l-bellier/cva6-ffturbo/report/results_on_board.png

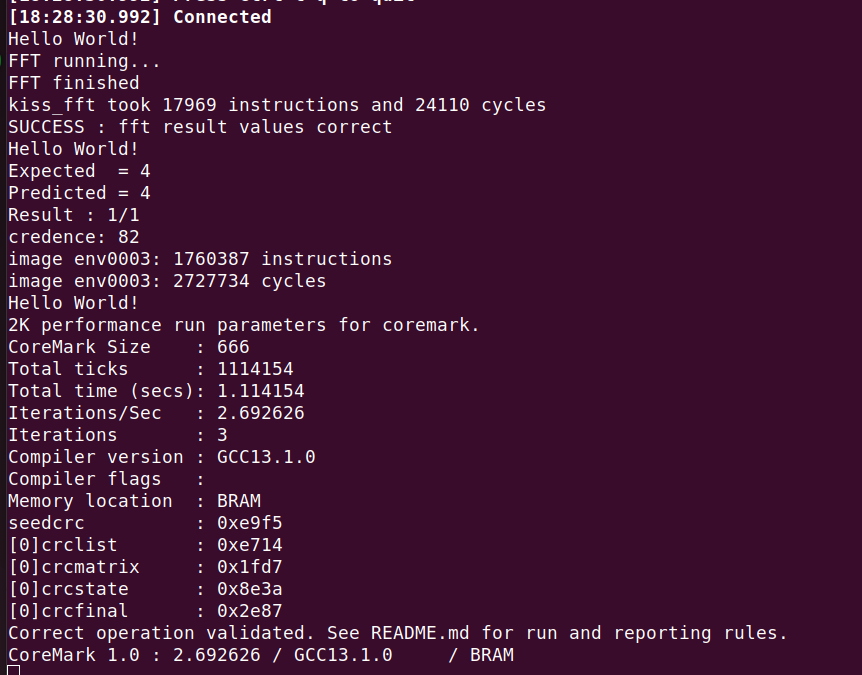
report/results_on_board.png
