l-bellier/cva6-ffturbo/report/simulation_results.png

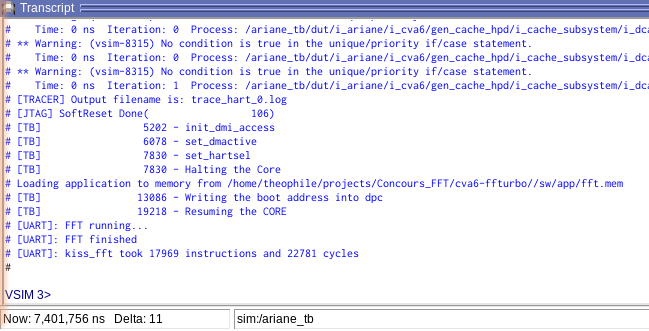
report/simulation_results.png
