l-bellier/cva6-ffturbo/core/macro_decoder.sv

// Copyright 2018 ETH Zurich and University of Bologna.
// Copyright and related rights are licensed under the Solderpad Hardware
// License, Version 0.51 (the "License"); you may not use this file except in
// compliance with the License.  You may obtain a copy of the License at
// http://solderpad.org/licenses/SHL-0.51. Unless required by applicable law
// or agreed to in writing, software, hardware and materials distributed under
// this License is distributed on an "AS IS" BASIS, WITHOUT WARRANTIES OR
// CONDITIONS OF ANY KIND, either express or implied. See the License for the
// specific language governing permissions and limitations under the License.
//
// Author: Rohan Arshid, 10xEngineers
// Date: 22.01.2024
// Description: Contains the logic for decoding cm.push, cm.pop, cm.popret, 
//              cm.popretz, cm.mvsa01, and cm.mva01s instructions of the 
//              Zcmp Extension

module macro_decoder #(
    parameter config_pkg::cva6_cfg_t CVA6Cfg = config_pkg::cva6_cfg_empty
) (
    input  logic [31:0] instr_i,
    input  logic        clk_i,                      // Clock
    input  logic        rst_ni,                     // Synchronous reset
    input  logic        is_macro_instr_i,           // Intruction is of macro extension
    input  logic        illegal_instr_i,            // From compressed decoder
    input  logic        is_compressed_i,
    input  logic        issue_ack_i,                // Check if the intruction is acknowledged
    output logic [31:0] instr_o,
    output logic        illegal_instr_o,
    output logic        is_compressed_o,
    output logic        fetch_stall_o,              //Wait while push/pop/move instructions expand
    output logic        is_last_macro_instr_o,
    output logic        is_double_rd_macro_instr_o
);

  // FSM States
  enum logic [2:0] {
    IDLE,
    INIT,
    PUSH_ADDI,
    POPRETZ_1,
    MOVE,
    PUSH_POP_INSTR_2
  }
      state_d, state_q;

  // Instruction Types
  enum logic [2:0] {
    PUSH,
    POP,
    POPRETZ,
    POPRET,
    MVA01S,
    MVSA01
  } macro_instr_type;

  // Temporary registers
  logic [3:0] reg_numbers, reg_numbers_q, reg_numbers_d;
  logic [11:0] stack_adj;
  logic [4:0] xreg1, xreg2, store_reg, store_reg_q, store_reg_d;
  logic [1:0] popretz_inst_q, popretz_inst_d;
  logic [11:0] offset_reg, offset_q, offset_d;
  logic [31:0] instr_o_reg;

  riscv::itype_t itype_inst;
  assign instr_o = instr_o_reg;
  always_comb begin
    illegal_instr_o            = 1'b0;
    fetch_stall_o              = 1'b0;
    is_last_macro_instr_o      = 1'b0;
    is_double_rd_macro_instr_o = 1'b0;
    is_compressed_o            = is_macro_instr_i ? 1'b1 : is_compressed_i;
    reg_numbers                = '0;
    stack_adj                  = '0;
    state_d                    = state_q;
    offset_d                   = offset_q;
    reg_numbers_d              = reg_numbers_q;
    store_reg_d                = store_reg_q;
    popretz_inst_d             = popretz_inst_q;

    if (is_macro_instr_i) begin

      unique case (instr_i[12:10])
        // push or pop
        3'b110: begin
          unique case (instr_i[9:8])
            2'b00: begin
              macro_instr_type = PUSH;
            end
            2'b10: begin
              macro_instr_type = POP;
            end
            default: begin
              illegal_instr_o = 1'b1;
              instr_o_reg     = instr_i;
            end
          endcase
        end
        // popret or popretz
        3'b111: begin
          unique case (instr_i[9:8])
            2'b00: begin
              macro_instr_type = POPRETZ;
            end
            2'b10: begin
              macro_instr_type = POPRET;
            end
            default: begin
              illegal_instr_o = 1'b1;
              instr_o_reg     = instr_i;
            end
          endcase
        end
        // mvq01s or mvsa01
        3'b011: begin
          unique case (instr_i[6:5])
            2'b01: begin
              macro_instr_type = MVSA01;
            end
            2'b11: begin
              macro_instr_type = MVA01S;
            end
            default: begin
              illegal_instr_o = 1'b1;
              instr_o_reg     = instr_i;
            end
          endcase
        end
        default: begin
          illegal_instr_o = 1'b1;
          instr_o_reg     = instr_i;
        end
      endcase

      // Calculate xreg1 & xreg2 for move instructions
      if (macro_instr_type == MVSA01 || macro_instr_type == MVA01S) begin
        if (instr_i[9:7] != instr_i[4:2]) begin
          xreg1 = {instr_i[9:8] > 0, instr_i[9:8] == 0, instr_i[9:7]};
          xreg2 = {instr_i[4:3] > 0, instr_i[4:3] == 0, instr_i[4:2]};
        end else begin
          illegal_instr_o = 1'b1;
          instr_o_reg     = instr_i;
        end
      end else begin
        xreg1 = '0;
        xreg2 = '0;
      end

      // push/pop/popret/popretz instructions
      unique case (instr_i[7:4])
        4'b0100: reg_numbers = 4'b0001;  // 4
        4'b0101: reg_numbers = 4'b0010;  // 5
        4'b0110: reg_numbers = 4'b0011;  // 6
        4'b0111: reg_numbers = 4'b0100;  // 7
        4'b1000: reg_numbers = 4'b0101;  // 8
        4'b1001: reg_numbers = 4'b0110;  // 9
        4'b1010: reg_numbers = 4'b0111;  // 10
        4'b1011: reg_numbers = 4'b1000;  // 11
        4'b1100: reg_numbers = 4'b1001;  // 12
        4'b1101: reg_numbers = 4'b1010;  // 13
        4'b1110: reg_numbers = 4'b1011;  // 14
        4'b1111: reg_numbers = 4'b1100;  // 15
        default: reg_numbers = '0;
      endcase
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
