l-bellier/cva6-ffturbo/core/cva6_rvfi.sv

// Copyright 2024 Thales DIS France SAS
//
// Licensed under the Solderpad Hardware Licence, Version 2.0 (the "License");
// you may not use this file except in compliance with the License.
// SPDX-License-Identifier: Apache-2.0 WITH SHL-2.0
// You may obtain a copy of the License at https://solderpad.org/licenses/
//
// Original Author: Yannick Casamatta - Thales
// Date: 09/01/2024


module cva6_rvfi
  import ariane_pkg::*;
#(
    parameter config_pkg::cva6_cfg_t CVA6Cfg = config_pkg::cva6_cfg_empty,
    parameter type rvfi_instr_t = logic,
    parameter type rvfi_csr_t = logic,
    parameter type rvfi_probes_instr_t = logic,
    parameter type rvfi_probes_csr_t = logic,
    parameter type rvfi_probes_t = logic

) (

    input logic clk_i,
    input logic rst_ni,

    input rvfi_probes_t rvfi_probes_i,
    output rvfi_instr_t [CVA6Cfg.NrCommitPorts-1:0] rvfi_instr_o,
    output rvfi_csr_t rvfi_csr_o

);
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
