l-bellier/cva6-ffturbo/(commit log)

2025-10-31 Apply fix from cva6 main branch (#2833) for case when RVC is disabled
    [id_stage.sv]
2025-10-31 Apply fix from cva6 main branch (#2999)
    [cva6_hpdcache_subsystem.sv]
2025-10-31 Fix: align dtlb_ppn to virtual address instead of physical address when MMU is disabled
    [load_store_unit.sv]
2026-03-12 Fix RAW dependency for RS3 operand when coprocessor is used with CV-X-IF
    [issue_read_operands.sv]
2026-03-12 Correct a bug causing questa to throw an error when loading the coprocessor
    [instr_decoder.sv]
2026-03-12 Add check in ID stage before driving signals from RVC related logic
2026-03-16 Ajout des modules de sous fonction pour les papillons de taille 4 et 2
2026-03-16 Modification du coprocesseur pour intégrer les fonctions de papillons 2 et 4 pilotées par des instructions custom
2026-03-16 Modification des sources pour la compilation du cva6 et activation du coprocesseur dans le fichier config
2026-03-16 Correction définition de type et de package
    [bfly.sv, cvxif_instr_pkg.sv]
2026-03-16 Correction de l'ordre pour le résulat complex de la multiplication
    [c_mult.sv]
2026-03-16 Ajout d'une fonction bfly2 utilisant le coprocesseur ainsi qu'un fichier header définissant les instructions disponibles sur le coprocesseur
2026-03-16 Modification du coproceseur pour une meilleure intégration. Réponse un cycle après que l'instruction et ses registres soient valides
2026-03-16 Modification de la taille du vecteur m pour qu'il puisse prendre des valeurs jusqu'à 128
2026-03-16 Suppression d'un étage de la pipeline du module bfly, correction d'une erreur d'inversion dans cross_op et ajout d'une fonction bfly4_copro utilisant les fonctionnalités du coprocesseur
    [bfly.sv, cross_op.sv]
2026-03-18 Mise à jour du code C pour l'utilisation des buffers et réarangement des données via le code source
2026-03-18 Ajout de 2 nouvelles instructions sur le coprocesseur pour calculer les adresses du réarrangement de données
2026-03-18 Modification du code pour supporter et utiliser les nouvelles instructions
2026-03-18 Ajout des instructions custom dans le traceur d'instruction pour faciliter le debug
2026-03-24 Modification des paramètres du cva6 pour limiter les stalls lors de lectures ou d'écritures de beaucoup de données
    [cv32a6_im_contest_config_pkg.sv]
2026-03-24 Modification des fonctions de papillons utilisant le coprocesseur pour entrelacer les données et limiter les stalls
2026-03-25 Réduction de la fréquence du cva6 pour respecter les timings lors de l'implémentation, passage de 40MHz à 32MHz
2026-04-19 Diminution de la fréquence à 32 MHz en exécution
    D'après les modifications de la branche cv32a6_contest_25_26_clk-20pct du repo source.
2026-04-23 Ajout des fichiers timing et utilisation
